woo-laboratory-stanford/ALIVEVent/hardware/GH-Figure2-HardwareSetup.png

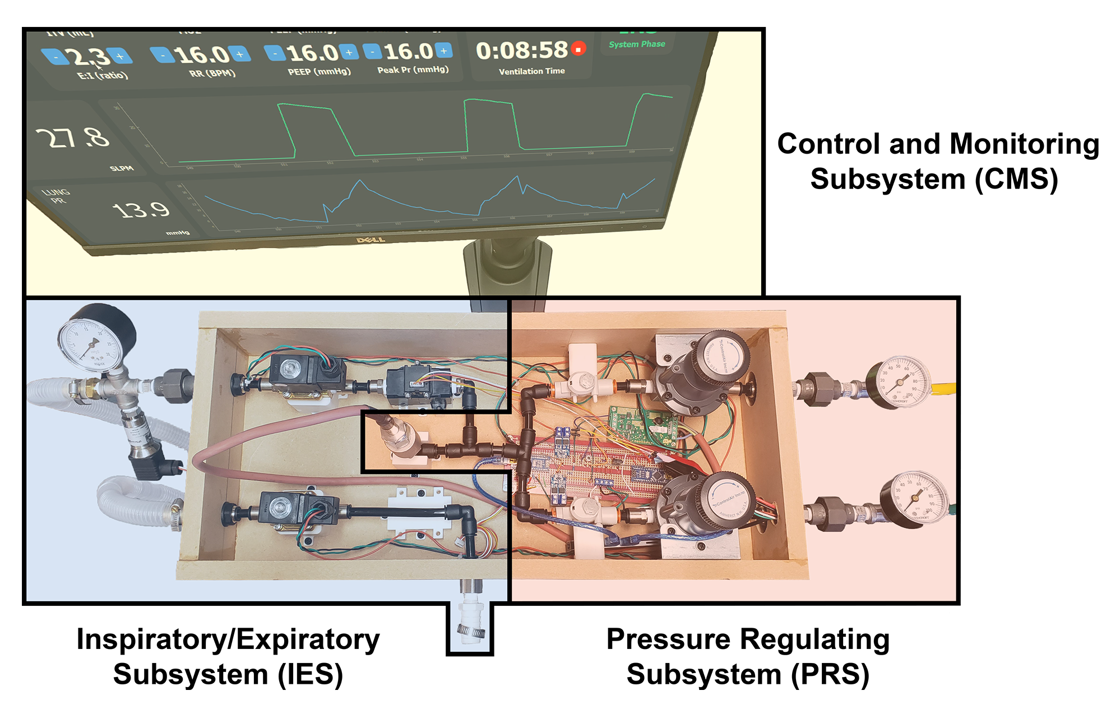
hardware/GH-Figure2-HardwareSetup.png
