woo-laboratory-stanford/ALIVEVent/hardware/BOM.pdf

Fig. S2. ALIVE Vent Bill of Materials (BOM) (A) BOM and cost breakdown of the ALIVE

Vent used in our testing setup. Note that electronics, microcontrollers, and computing equipment

were not included in the final BOM because implementation will vary largely based on the final

manifestation and the cost is minimal compared to the part cost. For example, computing could

be executed using a $100 Raspberry Pi or a smartphone. (B) BOM and cost breakdown of the

proposed ALIVE Vent to optimize for cost-efficiency. Most of the reduction in cost is due to the

use of a medical-grade electro-galvanic oxygen sensor as opposed to a zirconia oxygen sensor,

which we chose to use as to not contribute to the oxygen transducer shortage. Note that

electronics, microcontrollers, and computing equipment were not included in the final BOM

because implementation will vary largely based on the final manifestation. For example,

computing could be implemented using a $100 Raspberry Pi or a smartphone.

A
Item | Quantity | Estimated Price | Supplier | Hyperlink
Push-to-Connect Needle Valve | 2 | $ 72.00 | McMaster-Carr | Link (https://www.mcmaster.com/3019N114/)
Push-to-Connect Straight NPT Adapter | 8 | $ 40.00 | McMaster-Carr | Link (https://www.mcmaster.com/5779K116/)
Push-to-Connect Straight BSPT Adapter | 1 | $ 15.00 | McMaster-Carr | Link (https://www.mcmaster.com/5779K392/)
Push-to-Connect Tee Adapter | 2 | $ 14.00 | McMaster-Carr | Link (https://www.mcmaster.com/5779K36/)
Push-to-Connect Panel Mount Adapter | 5 | $ 65.00 | McMaster-Carr | Link (https://www.mcmaster.com/5779K273/)
Push-to-Connect Elbow to BSPT Adapter | 1 | $ 10.00 | McMaster-Carr | Link (https://www.mcmaster.com/5779K432/)
Push-to-Connect Elbow Adapter | 3 | $ 18.00 | McMaster-Carr | Link (https://www.mcmaster.com/5779K26/)
Push-to-Connect Elbow to NPT Adapter | 1 | $ 8.00 | McMaster-Carr | Link (https://www.mcmaster.com/5779K638/)
Firm Polyurethane Tubing | 0.1 | $ 2.60 | McMaster-Carr | Link (https://www.mcmaster.com/5648K26-5648K261/)
Stainless Steel NPT Union | 3 | $ 39.00 | McMaster-Carr | Link (https://www.mcmaster.com/4513K91-4513K91)
2-Way Solenoid Valve | 2 | $ 164.00 | McMaster-Carr | Link (https://www.mcmaster.com/4738K151/)
Pressure Regulator | 2 | $ 188.00 | McMaster-Carr | Link (https://www.mcmaster.com/1888k1-1888K11)
Flow Sensor | 1 | $ 137.00 | Honeywell | Link (https://www.onlinecomponents.com/honeywell/hafuht0100l4axt-46961928.html)
Pressure Sensor | 1 | $ 200.00 | Cynergy3 | Link (https://www.onlinecomponents.com/cynergy3/ipslugp001d-48159695.html)
Zirconia O2 Sensor | 1 | $ 200.00 | CO2 Meter | Link (https://www.co2meter.com/products/zirconia-oxygen-sensor-system)
Zirconia O2 Sensor – Interface Board | 1 | $ 200.00 | CO2 Meter | Link (https://www.co2meter.com/products/zirconia-oxygen-sensor-system?variant=31599941451894)
Total | $ 1,372.60

B

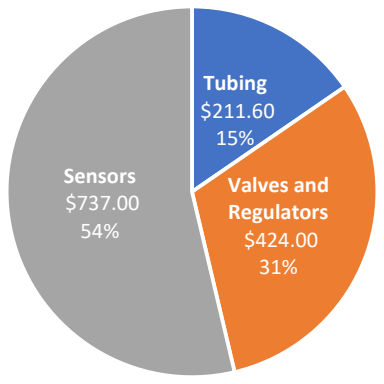
[picture p2: figure]
Tubing $211.60 15%; Valves and Regulators $424.00 31%; Sensors $737.00 54%

Item | Quantity | Estimated Price | Supplier | Hyperlink
Push-to-Connect Straight NPT Adapter | 8 | $ 40.00 | McMaster-Carr | Link (https://www.mcmaster.com/5779K116/)
Push-to-Connect Straight BSPT Adapter | 1 | $ 15.00 | McMaster-Carr | Link (https://www.mcmaster.com/5779K392/)
Push-to-Connect Tee Adapter | 2 | $ 14.00 | McMaster-Carr | Link (https://www.mcmaster.com/5779K36/)
Push-to-Connect Panel Mount Adapter | 5 | $ 65.00 | McMaster-Carr | Link (https://www.mcmaster.com/5779K273/)
Push-to-Connect Elbow to BSPT Adapter | 1 | $ 10.00 | McMaster-Carr | Link (https://www.mcmaster.com/5779K432/)
Push-to-Connect Elbow Adapter | 3 | $ 18.00 | McMaster-Carr | Link (https://www.mcmaster.com/5779K26/)
Push-to-Connect Elbow to NPT Adapter | 1 | $ 8.00 | McMaster-Carr | Link (https://www.mcmaster.com/5779K638/)
Firm Polyurethane Tubing | 0.1 | $ 2.60 | McMaster-Carr | Link (https://www.mcmaster.com/5648K26-5648K261/)
Stainless Steel NPT Union | 3 | $ 39.00 | McMaster-Carr | Link (https://www.mcmaster.com/4513K91-4513K91)
2-Way Solenoid Valve | 2 | $ 164.00 | McMaster-Carr | Link (https://www.mcmaster.com/4738K151/)
Pressure Regulator | 2 | $ 188.00 | McMaster-Carr | Link (https://www.mcmaster.com/1888k1-1888K11)
Pressure Sensor | 1 | $ 200.00 | Cynergy3 | Link (https://www.onlinecomponents.com/cynergy3/ipslugp001d-48159695.html)

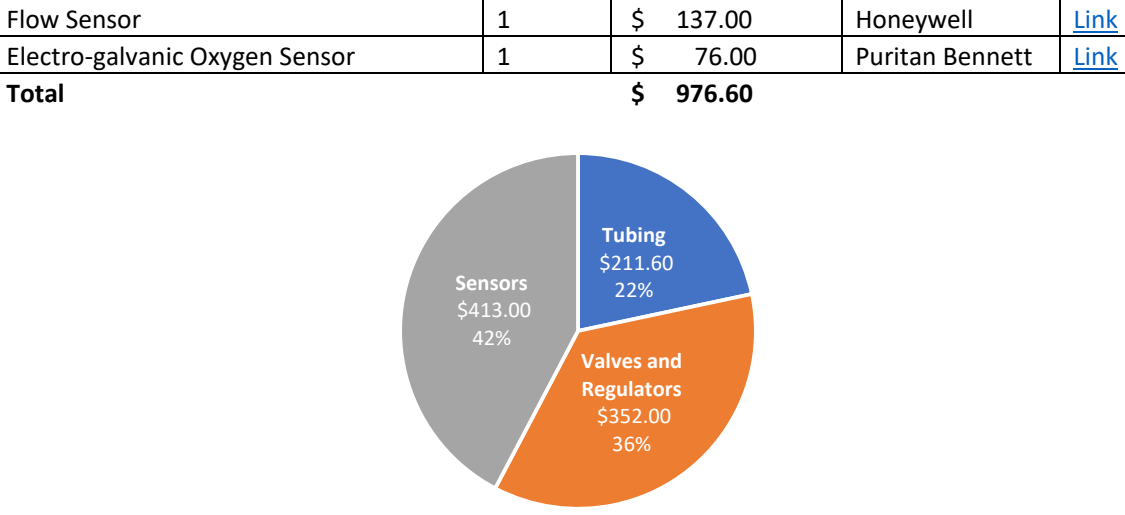
[picture p3: figure]
Flow Sensor; Honeywell; Link (https://www.onlinecomponents.com/honeywell/hafuht0100l4axt-46961928.html); Electro-galvanic Oxygen Sensor; Puritan Bennett; Link (https://www.cablesandsensors.com/products/compatible-o2-cell-for-hamilton-medical-396008?variant=33810165512); Total; Tubing $211.60 22%; Valves and Regulators $352.00 36%; Sensors $413.00 42%
